Gnuhry/Gartenhaus/README.md

# Gewächshaus

School project for german graduation 2019
