Gnuhry/Gartenhaus/Anhang/ESP 32 NodeMCU Developmentboard Pinout Diagram.pdf

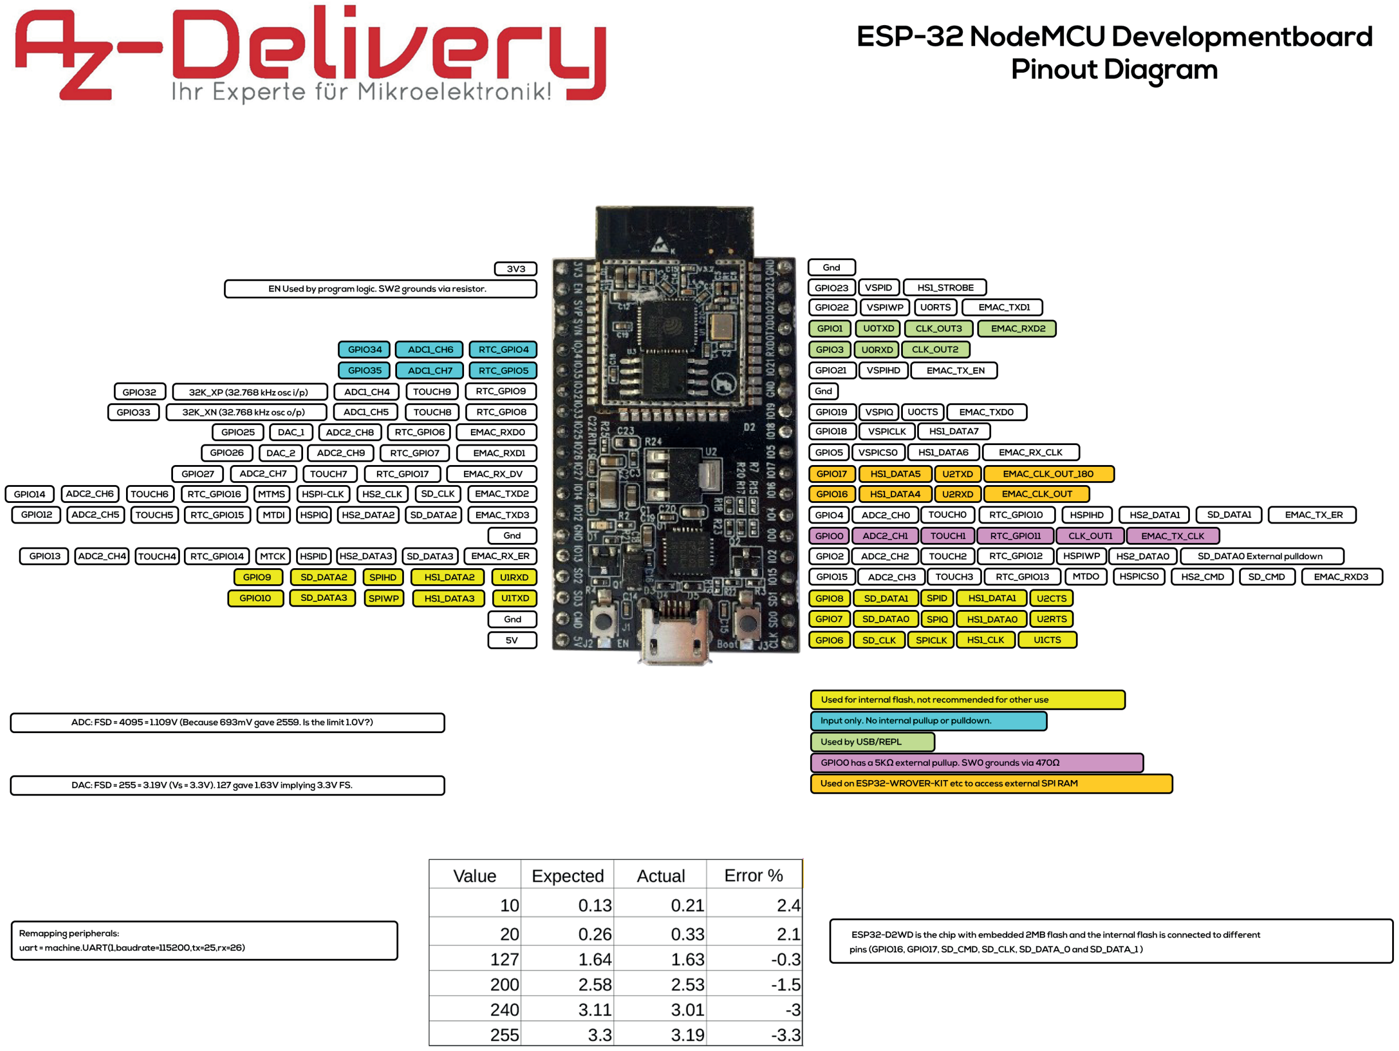
[picture p26: page 1]
