Gnuhry/Gartenhaus/Anhang/PAP.png

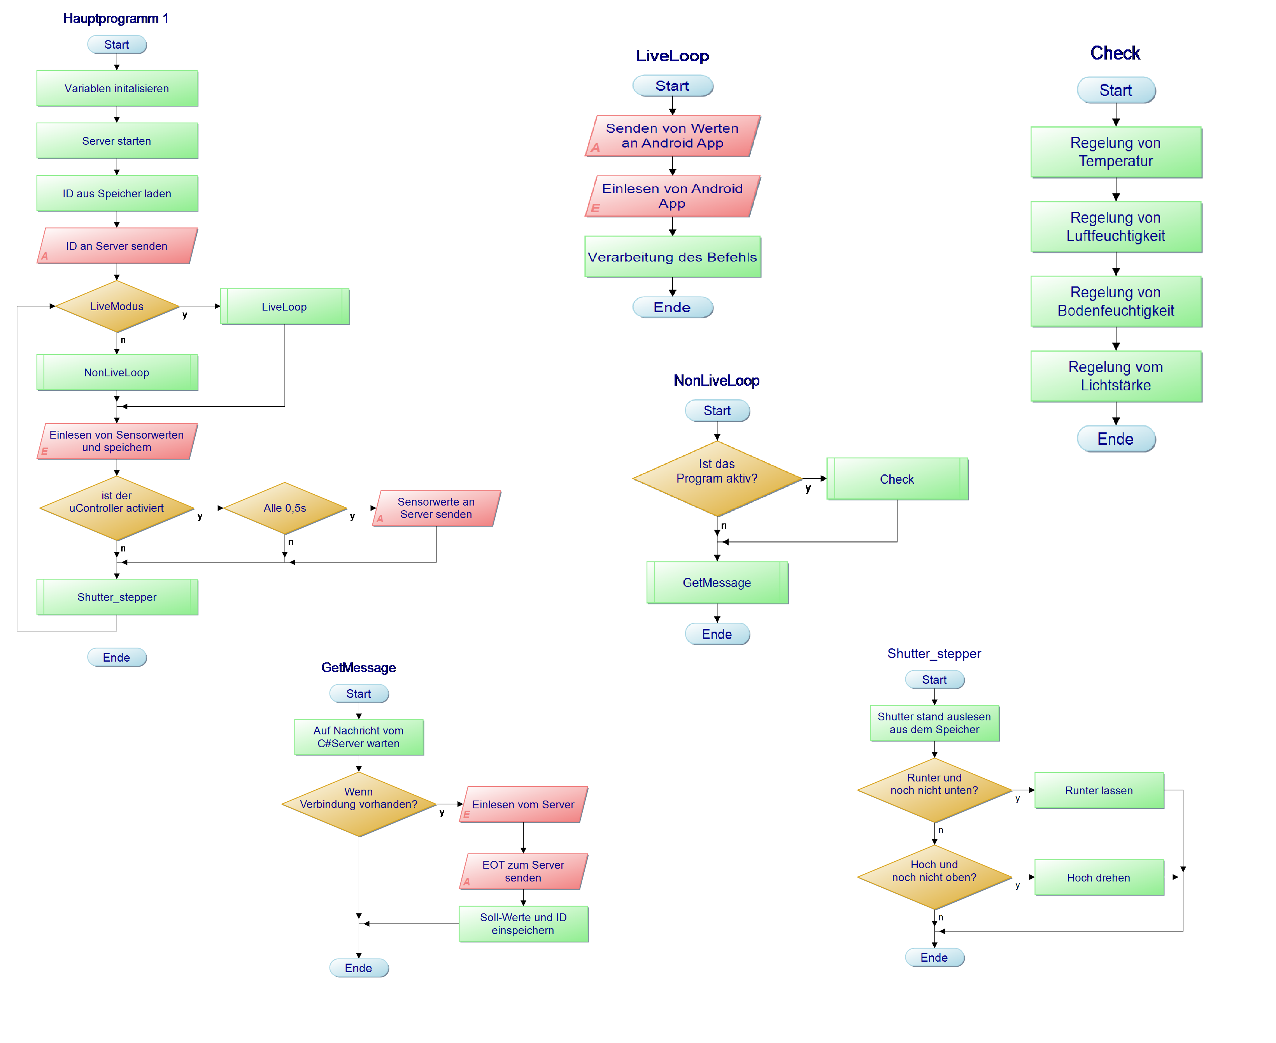
Anhang/PAP.png
