Gnuhry/Gartenhaus/Anhang/Schaltplan.png

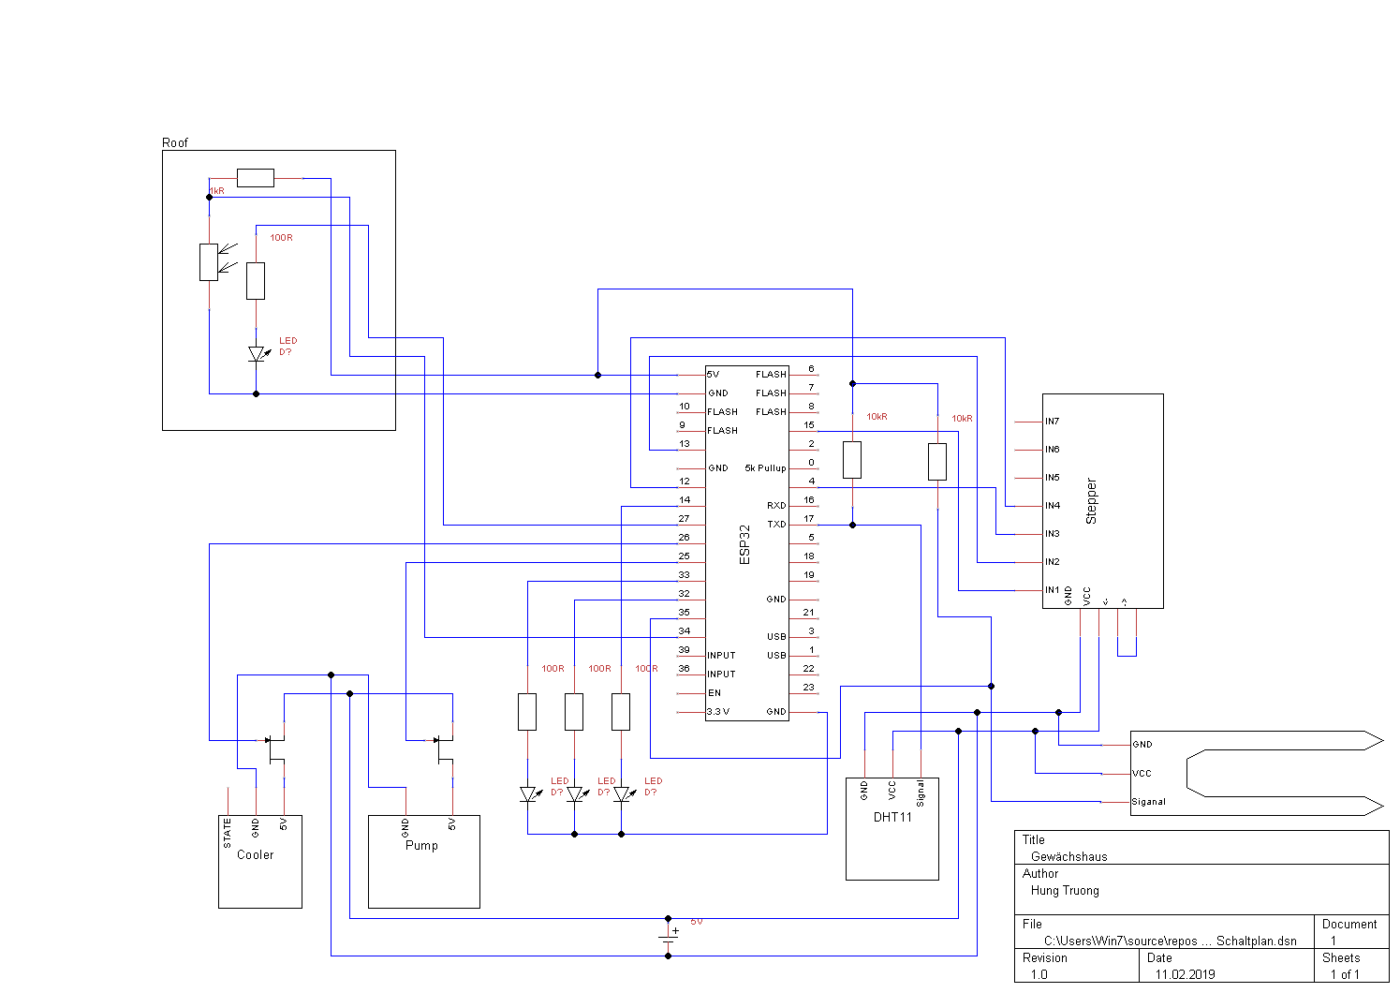
Anhang/Schaltplan.png
