Gnuhry/Gartenhaus/Anhang/Sequenzdiagramm.png

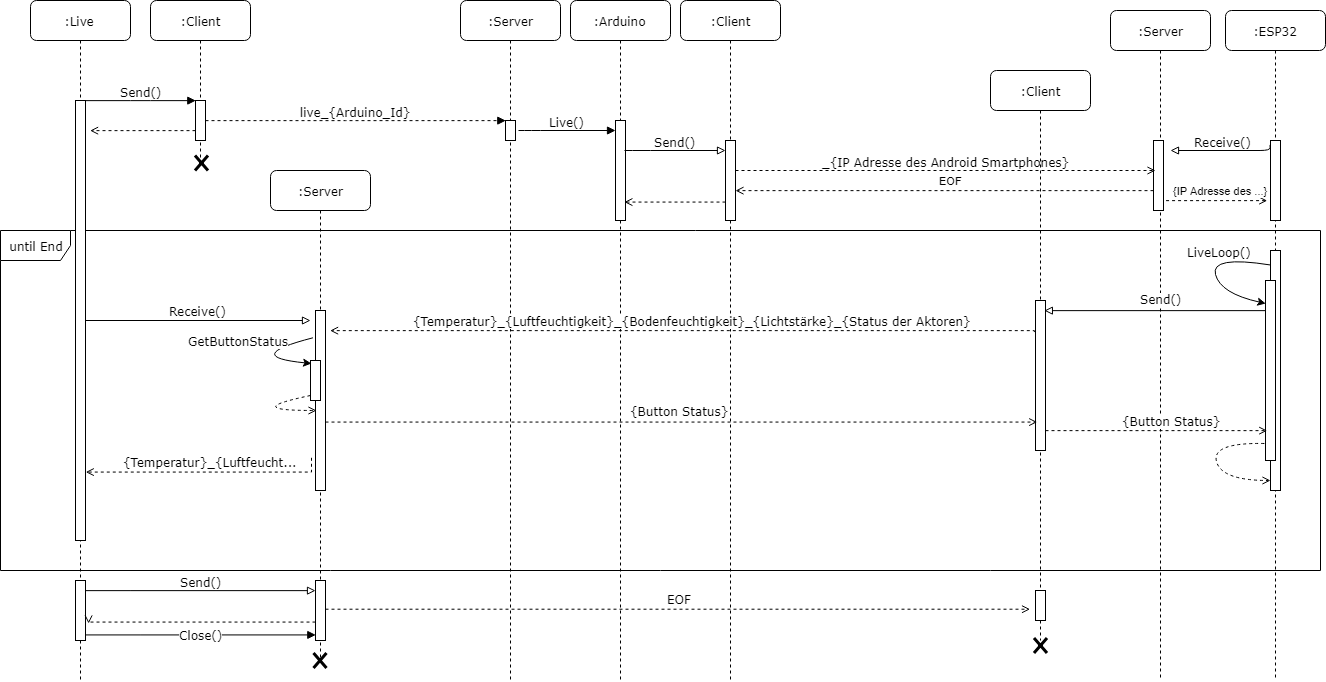
Anhang/Sequenzdiagramm.png
