Gnuhry/Gartenhaus/(list of files, drawings)

Other design files:
Anhang/Schaltplan.dsn
