Gnuhry/Gartenhaus/Android_Applikation/app/src/main/java/com/example/win7/gartenhausapp_2/Edit_Plant.java

package com.example.win7.gartenhausapp_2;

import android.content.Intent;
import android.os.Bundle;
import android.support.v7.app.AppCompatActivity;
import android.util.Log;
import android.view.View;
import android.widget.ArrayAdapter;
import android.widget.EditText;
import android.widget.Spinner;
import android.widget.Toast;

import java.util.ArrayList;
import java.util.List;

public class Edit_Plant extends AppCompatActivity {

    private Client client;
    private int ID;

    @Override
    protected void onCreate(Bundle savedInstanceState) {
        super.onCreate(savedInstanceState);
        setContentView(R.layout.activity_edit__plant);
        SetDownMenu();
        client = MainActivity.client;
        ID = getIntent().getIntExtra("ID", -1); //ID auslesen
        InitClickListner();
        SpinnerInitalisieren();
        if (ID < 1)
            return;
        findViewById(R.id.imVDeletePlaint).setVisibility(View.VISIBLE);
        String[] help = client.Send("get plant all_" + ID).split("_"); //Pflanzeninformationen vom Server holen
        try {
            Thread.sleep(500);
        } catch (InterruptedException e) {
            Toast.makeText(this, "Nope", Toast.LENGTH_SHORT).show();
        }
        if (help[0].equals(getString(R.string.error))) { //Kommunikationsfehler abfangen
            findViewById(R.id.edTName).setEnabled(false);
            findViewById(R.id.edTminHumid).setEnabled(false);
            findViewById(R.id.edTmaxGroundHumid).setEnabled(false);
            findViewById(R.id.edTmaxHumid).setEnabled(false);
            findViewById(R.id.edTminGroundHumid).setEnabled(false);
            findViewById(R.id.edTmaxTemp).setEnabled(false);
            findViewById(R.id.edTminTemp).setEnabled(false);
            findViewById(R.id.spinnerLight).setEnabled(false);
            ((EditText) findViewById(R.id.edTName)).setText(getString(R.string.error));
            findViewById(R.id.imVSavePlaint).setVisibility(View.GONE);
            return;
        }
        if (help.length < 2) return;
        ((EditText) findViewById(R.id.edTName)).setText(help[1]);
        ((EditText) findViewById(R.id.edTminTemp)).setText(help[2].replace(',', '.'));
        ((EditText) findViewById(R.id.edTmaxTemp)).setText(help[3].replace(',', '.'));
        ((EditText) findViewById(R.id.edTminGroundHumid)).setText(help[4].replace(',', '.'));
        ((EditText) findViewById(R.id.edTmaxGroundHumid)).setText(help[5].replace(',', '.'));
        ((EditText) findViewById(R.id.edTminHumid)).setText(help[6].replace(',', '.'));
        ((EditText) findViewById(R.id.edTmaxHumid)).setText(help[7].replace(',', '.'));
        ((Spinner) findViewById(R.id.spinnerLight)).setSelection(Integer.parseInt(help[8]));
    }

    private void SpinnerInitalisieren() {
        Spinner spinner = findViewById(R.id.spinnerLight);
        List<String> spinnerlist = new ArrayList<>();
        spinnerlist.add("sehr empfindlich");
        spinnerlist.add("empfindlich");
        spinnerlist.add("grob empfindlich");
        ArrayAdapter<String> arrayAdapter = new ArrayAdapter<>(this, android.R.layout.simple_spinner_item, spinnerlist);
        arrayAdapter.setDropDownViewResource(android.R.layout.simple_spinner_dropdown_item);
        spinner.setAdapter(arrayAdapter);
        spinner.setSelection(1);
    }
    private void SetDownMenu(){
        findViewById(R.id.downbar).setBackgroundResource(R.drawable.pflanze);
        findViewById(R.id.imVPlant).setOnClickListener(new View.OnClickListener() {
            @Override
            public void onClick(View view) {
                startActivity(new Intent(getApplicationContext(), Main2Activity.class));
            }
        });
        findViewById(R.id.imVHome).setOnClickListener(new View.OnClickListener() {
            @Override
            public void onClick(View view) {
                startActivity(new Intent(getApplicationContext(), MainActivity.class));
            }
        });
        findViewById(R.id.imVRegler).setOnClickListener(new View.OnClickListener() {
            @Override
            public void onClick(View view) {
                startActivity(new Intent(getApplicationContext(), Main3Activity.class));
            }
        });
    }

    private void InitClickListner() {
        findViewById(R.id.imVSavePlaint).setOnClickListener(new View.OnClickListener() {
            /**
             * Click Listner for Save Button
             */
            @Override
            public void onClick(View view) {
                String name = ((EditText) findViewById(R.id.edTName)).getText().toString();
                String MinTemp = ((EditText) findViewById(R.id.edTminTemp)).getText().toString();
                String MaxTemp = ((EditText) findViewById(R.id.edTmaxTemp)).getText().toString();
                String MinGroundHumid = ((EditText) findViewById(R.id.edTminGroundHumid)).getText().toString();
                String MaxGroundHumid = ((EditText) findViewById(R.id.edTmaxGroundHumid)).getText().toString();
                String MinHumid = ((EditText) findViewById(R.id.edTminHumid)).getText().toString();
                String MaxHumid = ((EditText) findViewById(R.id.edTmaxHumid)).getText().toString();

                if (name.trim().equals("") || MinTemp.equals("") || MaxTemp.equals("") || MinGroundHumid.equals("") ||
                        MaxGroundHumid.equals("") || MinHumid.equals("") || MaxHumid.equals("")) {
                    Toast.makeText(getApplicationContext(), getString(R.string.edit_all), Toast.LENGTH_LONG).show();
                    return;
                }
                if (Float.parseFloat(MinTemp) > 50 || Float.parseFloat(MinTemp) < -20 || Float.parseFloat(MaxTemp) > 50 || Float.parseFloat(MaxTemp) < -20) {
                    Toast.makeText(getApplicationContext(), R.string.tempValue, Toast.LENGTH_LONG).show();
                    return;
                }
                if (Float.parseFloat(MinHumid) > 100 || Float.parseFloat(MinHumid) < 0 || Float.parseFloat(MaxHumid) > 100 || Float.parseFloat(MaxHumid) < 0) {
                    Toast.makeText(getApplicationContext(), R.string.humidValue, Toast.LENGTH_LONG).show();
                    return;
                }
                if (Float.parseFloat(MinGroundHumid) > 100 || Float.parseFloat(MinGroundHumid) < 0 || Float.parseFloat(MaxGroundHumid) > 100 || Float.parseFloat(MaxGroundHumid) < 0) {
                    Toast.makeText(getApplicationContext(), R.string.humidValue, Toast.LENGTH_LONG).show();
                    return;
                }
                if (Float.parseFloat(MinTemp) > Float.parseFloat(MaxTemp)) {
                    Toast.makeText(getApplicationContext(), R.string.minGmaxTemp, Toast.LENGTH_LONG).show();
                    return;
                }
                if (Float.parseFloat(MinHumid) > Float.parseFloat(MaxHumid)) {
                    Toast.makeText(getApplicationContext(), getString(R.string.minGmaxHumid), Toast.LENGTH_LONG).show();
                    return;
                }
                if (Float.parseFloat(MinGroundHumid) > Float.parseFloat(MaxGroundHumid)) {
                    Toast.makeText(getApplicationContext(), getString(R.string.minGmaxGroundHumid), Toast.LENGTH_LONG).show();
                    return;
                }
                if (ID != -1) {
                    Log.e("Change", client.Send("set plant_" + ID + "_" + name + "_" + MinTemp.replace('.', ',') +
                            "_" + MaxTemp.replace('.', ',') + "_" + MinGroundHumid.replace('.', ',') + "_" + MaxGroundHumid.replace('.', ',') +
                            "_" + MinHumid.replace('.', ',') + "_" + MaxHumid.replace('.', ',') +
                            "_" + ((Spinner) findViewById(R.id.spinnerLight)).getSelectedItemPosition()));
                } else {
                    Log.e("Add", client.Send("new plant_" + name + "_" + MinTemp.replace('.', ',') + "_" + MaxTemp.replace('.', ',') + "_" + MinGroundHumid.replace('.', ',') +
                            "_" + MaxGroundHumid.replace('.', ',') + "_" + MinHumid.replace('.', ',') + "_" + MaxHumid.replace('.', ',') +
                            "_" + ((Spinner) findViewById(R.id.spinnerLight)).getSelectedItemPosition()));
                }
                Close();
            }
        });
        if (ID != -1)
            findViewById(R.id.imVDeletePlaint).setOnClickListener(new View.OnClickListener() {
                /**
                 * Click Listener for Delete Button
                 */
                @Override
                public void onClick(View view) {
                    Log.e("Delete", client.Send("delete arduino_" + ID));
                    Close();
                }
            });
    }

    private void Close() {
        Intent intent = new Intent(this, Main2Activity.class);
        startActivity(intent);
    }
}
