Gnuhry/Gartenhaus/(commit log)

2018-10-06 Fixing Add New Plant
    [Edit_Plant.java]
2018-10-06 Fixing Arduino Anzeige
2018-10-07 Fixing Table DataX Problem
    [Edit_Arduino.java]
2018-10-16 Bugfix Arduino C# Communication
    [Empfanger.ino, Sender.ino]
2018-10-24 Bugfixes Server & Android
    [Edit_Arduino.java, Main3Activity.java, Sender.ino]
2018-10-24 Refactoring Arduino
2018-10-25 Bugfix Arduino NodeMCU
2018-12-18 New Arduino
2019-01-14 Reload Button
2019-03-20 NEW UI
    [Schaltplan.dsn]
